andrew-abdelmalak/4-dof-service-manipulator/docs/4DOF_Service_Manipulator.pdf

# Design, Kinematic Analysis, and Experimental Validation of a 4-DOF Service Robotic Manipulator for Automated Beverage Preparation

Andrew Abdelmalak
Dept. of Mechatronics Engineering German University in Cairo (GUC) Cairo, Egypt

Daniel Boules
Dept. of Mechatronics Engineering German University in Cairo (GUC) Cairo, Egypt

David Girgis
Dept. of Mechatronics Engineering German University in Cairo (GUC) Cairo, Egypt

Kirolous Kirolous
Dept. of Mechatronics Engineering German University in Cairo (GUC) Cairo, Egypt

Samir Yacoub
Dept. of Mechatronics Engineering German University in Cairo (GUC) Cairo, Egypt

Youssef Salama
Dept. of Mechatronics Engineering German University in Cairo (GUC) Cairo, Egypt

Abstract—This paper presents the complete design, kinematic analysis, simulation, and experimental validation of a desktopscale 4-DOF service robotic manipulator for automated beverage preparation. The manipulator is constructed from 3D-printed PLA components and actuated by three MG996R high-torque servos and three SG90 micro servos. Kinematic modeling follows the Denavit–Hartenberg convention with link lengths d1 = 0.04355 m, a2 = 0.140 m, a3 = 0.133 m, and a4 = 0.109 m. A numerical Newton–Raphson inverse kinematics solver achieves sub-millimeter position convergence (< 10⁻⁴ m in ROS Python using Damped Least-Squares regularization with λ = 0.01, and < 10⁻³ m in MATLAB using the Moore–Penrose pseudoinverse), while warm-start joint recovery and undamped velocity roundtrip tests achieve machine-precision residuals (10⁻¹⁷ rad and ≤ 2.2 × 10⁻¹⁵ rad/s). Two task-space trajectories—a three-sided square path for pick-and-place operations and a circular path for stirring—are implemented and validated across Gazebo, Simscape Multibody, and physical hardware platforms. A tea-preparation demonstration involving sugar transport, spoon manipulation, and stirring confirms the system’s capability for coordinated multi-step service tasks using accessible, educationalgrade hardware.
Index Terms—Service robotics, robotic manipulator, Denavit– Hartenberg convention, inverse kinematics, trajectory planning, beverage preparation, 3D printing, Gazebo, Simscape.
I. INTRODUCTION
Service robotics is increasingly transforming customeroriented industries by automating tasks that demand consistency, hygiene, and precision. Among these applications, beverage preparation has emerged as a key domain where robots can deliver uniform quality while reducing human workload [1]. Recent studies have demonstrated the growing acceptance of robotic baristas and automated food preparation systems, where robots are valued for their ability to operate continuously without fatigue.
Several robotic coffee preparation systems have been proposed. Setiawan and Ma’arif [2] developed a PLC-based coffee-stirring system with PID control, demonstrating how controlled motion improves drink uniformity and prevents spillage. Michalkova et al. [3] automated an espresso machine ´ using a FANUC industrial arm and PLC logic, validating high-precision manipulators in cafe settings. Nurba et al. [4] ´ developed a 3-DOF manipulator applying Denavit–Hartenberg (DH) forward kinematics, achieving repeatability deviations below 0.06 mm. Salman et al. [5] employed the DH convention to model a 3-DOF arm with MATLAB GUI simulation and Arduino-based actuation, while Waluyo et al. [6] demonstrated an Arduino-based robot arm for coffee preparation. However, most existing systems either target industrialscale automation or are limited to single-function prototypes. Limited attention has been given to compact, educationalgrade manipulators tailored for multi-step service applications using accessible components. This paper addresses this gap through five contributions:
1) Design and fabrication of a 4-DOF desktop manipulator using 3D-printed parts and locally sourced servos.
2) Complete DH-based kinematic modeling including forward kinematics, numerical inverse kinematics, and velocity kinematics with analytical Jacobian derivation.
3) Dual-platform simulation validation in both Gazebo (ROS-integrated) and MATLAB Simscape Multibody.
4) Task-space trajectory planning with square (pick-andplace) and circular (stirring) paths.
5) Experimental validation on physical hardware through a tea-preparation demonstration.

II. SYSTEM DESIGN

A. Mechanical Architecture

The manipulator possesses 4 Degrees of Freedom (DOF) and is constructed primarily from 3D-printed PLA parts, ensuring a lightweight yet rigid structure (Fig. 1). The arm is actuated by six servo motors: three high-torque MG996R

(180◦
, metal gear) servos for the base, shoulder, and elbow joints, and three SG90 micro servos (180◦
, plastic gear) for
the wrist and gripper. One SG90 servo serves as a fixed dummy pivot to maintain the 4-DOF kinematic chain. Table I summarizes the primary components.

TABLE I: Hardware Components

Component | Qty
3D Printed Parts (PLA) | 1 set
MG996R Servo Motors | 3
SG90 Micro Servos | 3
Arduino Uno | 1
Power Supply (12V) | 1
B. End-Effector Design

A parallel gripper serves as the primary end-effector, providing sufficient range and gripping force for lightweight objects such as cups and utensils. The inner surfaces of the jaws are lined with high-friction material to ensure stable grasping. The same gripper can hold a teaspoon attachment for instant beverage preparation, dispensing coffee powder or sugar before stirring—preserving modularity without additional toolchanging mechanisms.

C. Electronics and Communication

The system is powered by a 12V DC supply with a DC-DC step-down converter for voltage regulation. Control logic is executed on an Arduino Uno, which generates PWM signals to control servo positions. Communication between the PC-based trajectory planner and the Arduino operates at 115,200 baud using comma-separated joint angle strings (e.g., "90,45,-30,0") with dedicated gripper commands
(GRIPPER_OPEN, GRIPPER_CLOSE). A handshake proto-
col using a "READY" acknowledgment signal ensures motion synchronization. Table II summarizes the pin assignments.

TABLE II: Arduino Pin Assignments and Calibration

Joint | Pin | Calibration
Base (J1) | 3 | q + 90◦
Shoulder (J2) | 5 | −q + 110◦
Elbow (J3) | 6 | −q + 90◦
Wrist (J4) | 9 | −q + 110◦
Gripper | 10 | q + 90◦ (clamped)

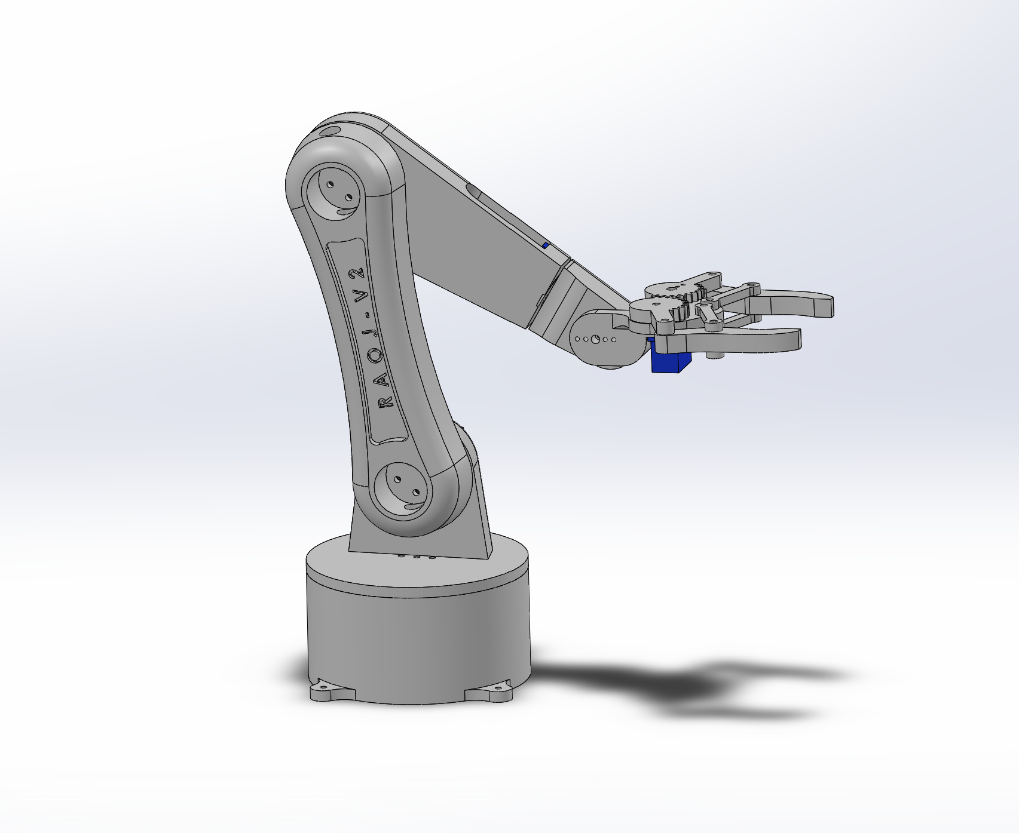
[picture p1: figure]

Fig. 1: CAD model of the 4-DOF robotic manipulator showing the joint arrangement and structural proportions.

III. KINEMATIC MODELING

A. Coordinate Frames and DH Parameters

Coordinate frames were assigned following the Denavit– Hartenberg convention [7], [8] using the X–Z rule (Fig. 2). The axes x1, x2, and x3 lie in the same plane, while z1 and z4 are parallel. The z3 axis is oriented opposite to z1 and z4, consistent with the DH convention for this manipulator. The resulting DH parameters are listed in Table III.

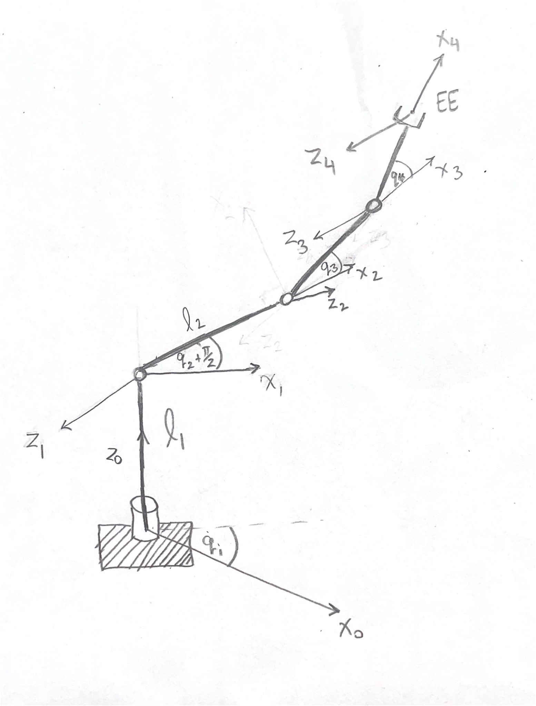
[picture p2: figure]

Fig. 2: Denavit–Hartenberg coordinate frame assignment for the 4-DOF manipulator.

TABLE III: Denavit–Hartenberg Parameters

Link | θi | di (m) | ai (m) | αi (rad)
1 | q1 | 0.04355 | 0 | π/2
2 | q2 + π/2 | 0 | 0.140 | π
3 | q3 | 0 | 0.133 | π
4 | q4 | 0 | 0.109 | 0
B. Forward Kinematics
The forward kinematics function F(q) computes the end-effector position X = [x, y, z]
| | T
from the joint vector q =
[q1, q2, q3, q4]

T
. Each link transformation is computed using the standard DH matrix:

i−1Ti =

cθi −sθi
cαi
| | sθi
| | sαi | aicθi
sθi | cθi
| cαi | −cθi
sαi | aisθi
0 | sαi | cαi | di
0 | 0 | 0 | 1

(1)

where cθi = cos θi and sθi = sin θi . The global transformation is obtained as 0T4 = 0T1 ·

1T2 ·

2T3 ·

3T4. For the zero joint
configuration (q1 = q2 = q3 = q4 = 0), the end-effector is elevated to z = 0.42555 m along the base z-axis, which equals d1 + a2 + a3 + a4 = 0.04355 + 0.140 + 0.133 + 0.109 m. The FK model was implemented identically in both MAT-
LAB (forward_kinematics_func.m) and Python (ROS
module forward_kinematics.py), ensuring consistent results across analytical computation and simulation.
C. Inverse Position Kinematics
Since the manipulator has 4 DOF but targets 3D Cartesian positions without full 6-DOF end-effector orientation constraints, the position kinematics problem is solved numerically using Newton–Raphson iterations over the 3 × 4 linear Jacobian. The position error is defined as:
ek = Xdes − F(qk) | (2)

In the ROS/Python implementation, the joint angle update uses a Damped Least-Squares (DLS) formulation:

∆q = J

T
v

(q)

Jv(q)J

T
v
(q) + λ

2
I3

−1
e | (3)

where Jv(q) ∈ R

3×4
is the analytical position Jacobian and λ = 0.01 is the damping factor for stability near singularities (whereas the MATLAB solver uses the undamped Moore– Penrose pseudoinverse J

+
v

(q)e).

D. Analytical Jacobian
The 3 × 4 position Jacobian Jv(q) = ∂F/∂q was derived analytically from F(q) = [−c1R, −s1R, d1 + l2c2 + l3cδ + l4cσ]

T
, where δ = q2 − q3, σ = q2 − q3 + q4, s1 = sin q1, c1 = cos q1, R = l2s2 + l3sδ + l4sσ, C = l2c2 + l3cδ + l4cσ, R′ = l3sδ + l4sσ, and C

′ = l3cδ + l4cσ:

Jv =

s1R | −c1C c1C
′ | −l4cσc1
−c1R −s1C s1C
′ | −l4cσs1
0 | −R | R′ | −l4sσ
- (4)

This analytical Jacobian matches central finite differences of F(q) to within 10⁻⁹
across random workspace configurations.
E. Velocity Kinematics

Forward velocity kinematics relates joint velocities q˙ to the end-effector twist V = [vx, vy, vz, ωx, ωy, ωz]

T via the 6 × 4
geometric Jacobian:

V = J(q) · q˙ =

Jv(q)
Jω(q)
q˙ | (5)

The inverse velocity kinematics recovers joint velocities from a desired twist using the pseudo-inverse:

q˙ = J

+(q) · Vdes | (6)

Validation was performed by commanding joint velocities in Gazebo, computing the theoretical end-effector velocity Vtheory = J(q)q˙ , and comparing it against the numerical velocity obtained from finite-difference position measurements. Both values showed close agreement, confirming the correctness of the Jacobian.

IV. TRAJECTORY PLANNING

The trajectory planner generates a sequence of end-effector positions X(t) = [x(t), y(t), z(t)]T
sampled at Ts = 0.1 s.
The IK solver converts these into joint angle sequences q(t).
A. Square Trajectory (Pick-and-Place)

The square trajectory is defined in the Y –Z plane as a three-sided “gate-like” path connecting four waypoints for pick-and-place operations. The motion sequence consists of:
(1) vertical ascent from the pickup location P1 to a safe height P2; (2) horizontal translation at the safe height to the drop-off column P3; and (3) vertical descent to the placement point P4. Position is linearly interpolated between consecutive waypoints:

P(t) = Pstart +

t
Tf
| (Pend − Pstart) | (7)

where Tf = 2.0 s per segment in MATLAB (3.0 s in the ROS trajectory node).

B. Circular Trajectory (Stirring)

The circular trajectory is defined in the X–Y plane for stirring operations. Given center C = [cx, cy, cz] and radius r:

θ(t) = 2π

Ttotal

| · t | (8)
x(t) = cx + r cos θ(t) | (9)
y(t) = cy + r sin θ(t) | (10)
z(t) = cz | (constant) | (11)

This ensures smooth continuous motion with constant angular velocity ω = 2π/Ttotal, where Ttotal = 10 s. Table IV summarizes the key planning parameters.

TABLE IV: Trajectory and IK Solver Parameters

Parameter | Value
Sampling time Ts | 0.1 s
Square segment duration Tf | 2.0 s (MATLAB) / 3.0 s (ROS)
Circle total duration Ttotal | 10 s
Damping factor λ | 0.01 (ROS DLS) / 0 (MATLAB pinv)
IK max iterations | 100 (MATLAB) / 500 (ROS)
Position tolerance ∥e∥ | 10⁻³ m (MATLAB) / 10⁻⁴ m (ROS)
V. SIMULATION AND VALIDATION
A. Dual-Platform Simulation

The kinematic model and trajectories were validated in two simulation environments: Gazebo (physics-based, ROS-integrated) and Simscape Multibody (system-level, MATLAB/Simulink). In Gazebo, Python ROS nodes published joint commands to the robot URDF model and queried the end-effector link pose via the /gazebo/get_link_state
service | (my_robot::EE_frame | at | 30 Hz,
republished | to | /end_effector_pose | by
ee_pose_from_gazebo.py). In Simscape, the CAD assembly was imported into Simulink with MATLAB Function blocks computing FK for direct comparison.
Both environments produced end-effector positions matching the analytical model for all tested configurations. Fig. 3 shows the robot models in both simulation environments.

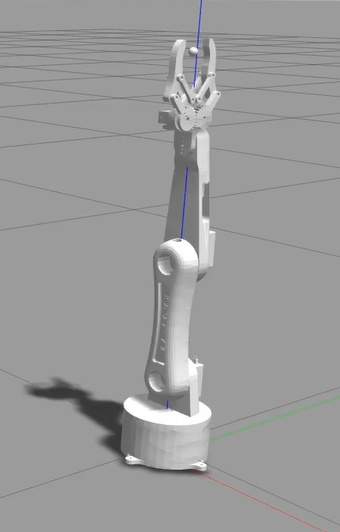
[picture p3: figure]
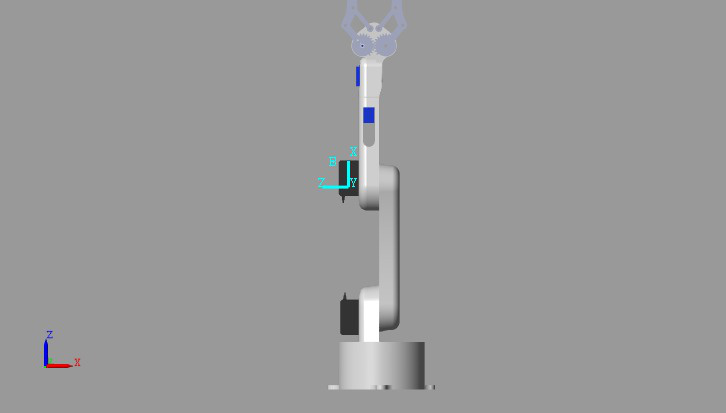
[picture p4: figure]

(a) Simscape Multibody | (b) Gazebo

Fig. 3: Robot models in both simulation environments.

B. Forward Kinematics Verification

Table V presents the FK verification results verified in both GNU Octave/MATLAB and Python, showing end-effector positions and velocities for two test configurations. The zeroconfiguration case yields the exact theoretical sum z = 0.42555 m (0.426 m rounded), confirming the DH parameter chain.

TABLE V: Kinematic Benchmark Test Cases

Case Input q (rad) | Output x (m) | Output V
1 | [0, 0, 0, 0] | [0, 0, 0.42555] | [0, 0, 0, 0, 0, 0.1]
2 | [0.2, 0.4, −0.3, 0.1] [−0.214, −0.043, 0.350] [−0.081, . . .]
C. Inverse Kinematics Roundtrip Validation

Three roundtrip tests were executed across both the Python solver (validate_roundtrip.py) and the Oc-
tave/MATLAB suite (test_velocity_kinematics.m),
summarized in Table VI. Starting from q0 = 0 (cold start), the position IK solver converges to within 5.66 × 10⁻⁵ m in Python (under 10⁻⁴ m tolerance) and 4.96 × 10⁻⁴ m in Octave/MATLAB. When warm-started at the target pose, ∥qrec − q∥ is zero to machine precision (≤ 1.39 × 10⁻¹⁷ rad). For velocity recovery, undamped Moore–Penrose pinv reproduces q˙ to 10⁻¹⁵ rad/s, whereas DLS regularization (λ = 0.01) introduces bounded bias up to 8.42 × 10⁻³
rad/s in exchange
for numerical stability near singularities.

TABLE VI: Python and Octave Roundtrip Validation

Case Input q (rad) | ∥ecold∥ (m) | ∥∆q˙ DLS∥ | ∥∆q˙ pinv∥
1 | [0, 0, 0, 0] | 0.00 | 1.00×10⁻⁵ | 0.00
2 | [0.2, 0.4, −0.3, 0.1] | 5.66×10⁻⁵ 5.00×10⁻³ 9.42×10⁻¹⁶
3 | [−0.3, 0.6, 0.2, −0.2] 5.45×10⁻⁵ 8.42×10⁻³ 1.18×10⁻¹⁵
D. Trajectory Validation

Both square and circular trajectories were executed in Gazebo and Simscape, with joint-angle sequences generated by the custom Python planner. Fig. 4 shows the trajectory validation results. For the square path, the four corners were traced with high fidelity and distinct transitions between linear segments. For the circular path, the end-effector maintained constant z-height while tracing a nearly perfect circle in the X–Y plane, with small deviations due to discretization and numerical IK residuals. The end-effector traces from Simscape closely matched Gazebo results, confirming cross-platform consistency despite differences in numerical integrators.

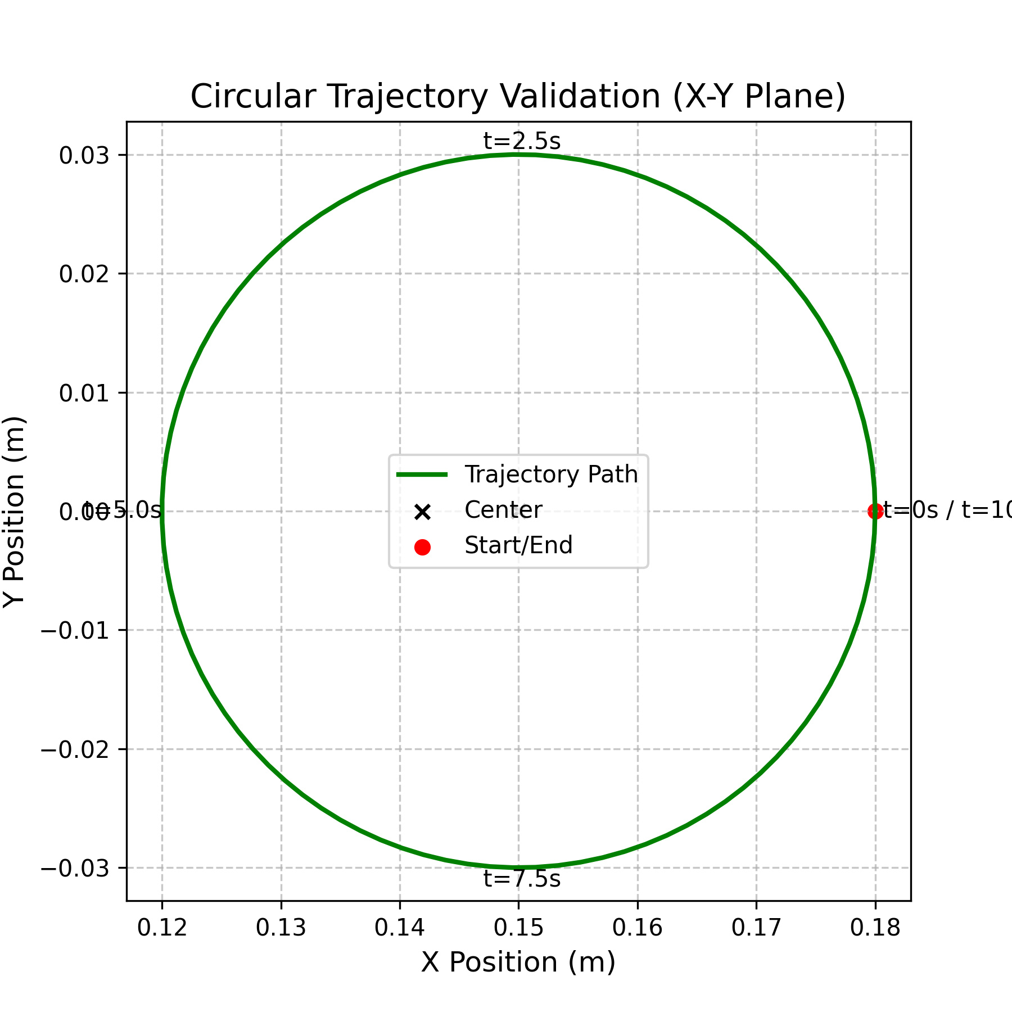
[picture p5: figure]
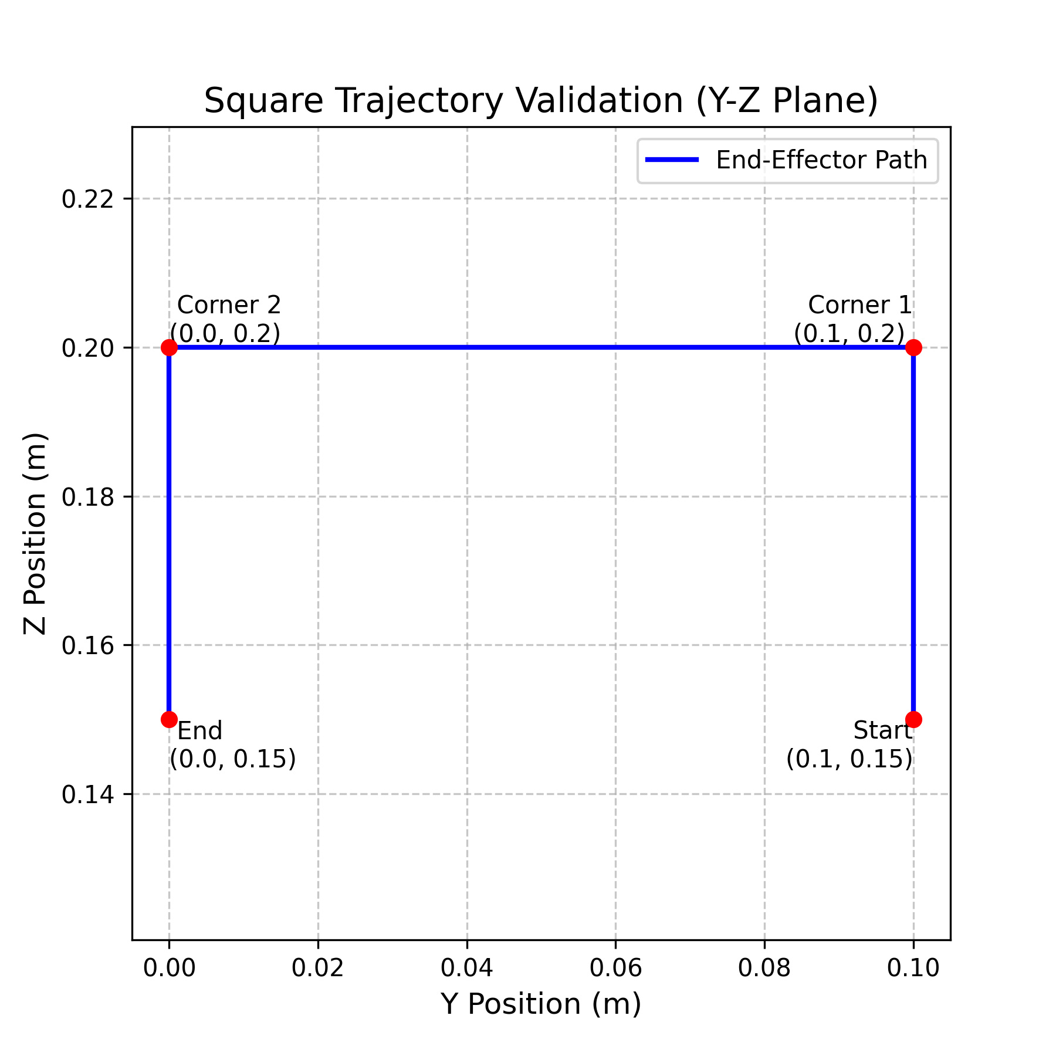
[picture p6: figure]

(a) Circular trajectory | (b) Square trajectory

Fig. 4: Task-space trajectory validation results from simulation.

VI. HARDWARE IMPLEMENTATION

A. Assembly and Wiring

The physical manipulator was fully assembled from 3D-printed PLA parts with all servo motors mounted at their respective joints (Fig. 6). The robot’s base is secured to a weighted wooden board to prevent tipping during highspeed movements. All electronics, including the Arduino Uno and motor connections, are housed in a protective enclosure. The circuit schematic (Fig. 5) shows the six servo motors connected to the Arduino’s PWM pins, with the 12V external power regulated through a DC-DC converter.

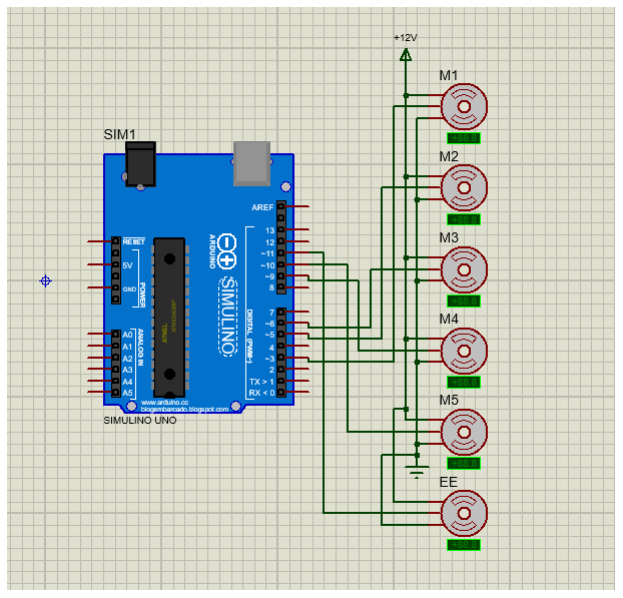
[picture p7: figure]

Fig. 5: Circuit schematic: Arduino Uno connected to six servo motors (M1–M5 and EE) via PWM pins, with 12V external power and common ground.

B. Open-Loop Validation

Initial hardware testing used Arduino scripts to sequentially actuate each motor through its full range of motion: base rotation, shoulder link, elbow link, wrist rotation, and gripper actuation. The fixed servo (motor 4) was confirmed stationary, consistent with the 4-DOF design. All active degrees of freedom responded correctly to commands, validating hardware readiness for trajectory execution.

C. Trajectory Execution

The joint-angle sequences computed by the trajectory planner were exported as CSV files and transmitted to the Arduino via a dedicated Python script (send_trajectory.py) that reads files line-by-line and waits for "READY" acknowledgments. The circular trajectory produced smooth, continuous motor movement, validating the 0.1 s time-step resolution. The square trajectory corners were reached with reasonable accuracy, with minor deviations attributed to mechanical backlash in servo gears and arm deflection under gravity at full extension.

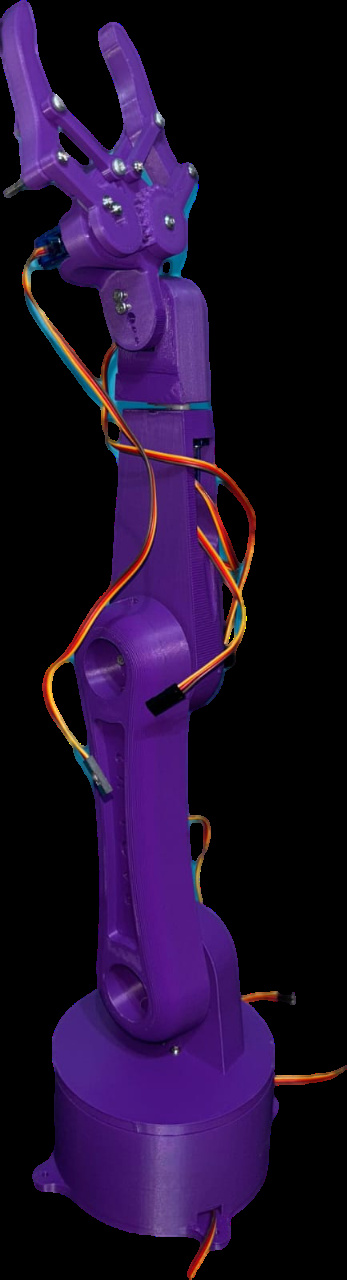
[picture p8: figure]

Fig. 6: Fully assembled 4-DOF robotic manipulator in the experimental setup.

VII. APPLICATION: TEA PREPARATION

The tea-preparation scenario serves as the primary validation task, demonstrating coordinated task-space motion and gripper actuation in a realistic service context. The complete task consists of five motion phases executed sequentially:

1) Sugar Transport: The manipulator executes the first square trajectory to pick up a sugar cube from its container, transport it, and release it into the cup.

2) Spoon Approach: A second square trajectory moves the end-effector to the spoon location and grasps the spoon handle.
3) Spoon Transport: The arm lifts the spoon and transports it toward the cup using a reverse square path.
4) Linear Centering: A short linear translation centers the spoon within the cup frame before stirring.
5) Stirring: The robot performs the circular trajectory for three full cycles (3 × 10 s), maintaining the spoon vertically inside the cup.
The complete 3D trajectory combining all phases is visualized in Fig. 7, illustrating the spatial relationship between the task objects (sugar container, spoon, cup) and the robot’s path.

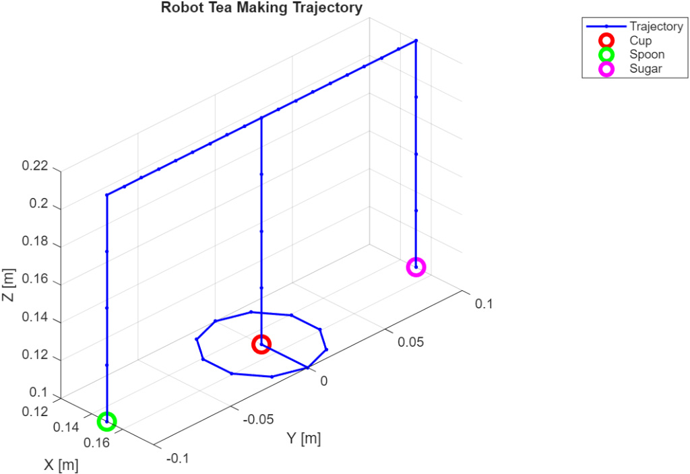
[picture p9: figure]

Fig. 7: 3D visualization of the complete tea-preparation trajectory, showing waypoints for sugar transport, spoon approach, and stirring.

Qualitatively, the hardware execution matched the simulation behavior. The square corners were clearly visible in the arm motion, and the circular stirring appeared smooth and repeatable. Small deviations from ideal paths arise from servo backlash, link flexibility, open-loop control, and slight misalignments between modeled and actual object positions. Despite these imperfections, the system successfully demonstrated coordinated multi-step manipulation in a practical service task.

VIII. DISCUSSION
The experimental results confirm that a low-cost, 3D-printed 4-DOF manipulator can perform multi-step beverage preparation tasks with acceptable repeatability for tabletop demonstrations. The DH-based kinematic model achieves sub-millimeter cold-start position convergence (< 10⁻⁴ m in ROS Python) and machine-precision velocity roundtrip residuals (≤ 2.2 × 10⁻¹⁵ rad/s under pinv), demonstrating that the analytical formulation is mathematically consistent across Octave/MATLAB and Python.
Two structural limitations shape the current platform. First, because the arm has 4 DOF operating in 3D workspace coordinates, position IK leaves end-effector orientation unconstrained rather than controlling full 6-DOF pose. Second, the physical hardware executes open-loop servo commands without encoder feedback, making joint angles susceptible to gear backlash and structural deflection under gravity, particularly at abrupt square-trajectory corners; the smoother circular trajectory exhibits noticeably less chatter.
The use of locally sourced components and 3D printing eliminates specialized industrial hardware, keeping the platform accessible for educational robotics laboratories.

IX. CONCLUSION
This paper presented the development of a 4-DOF service robotic manipulator, covering mechanical CAD design, DH kinematic modeling, ROS/Gazebo and Simscape simulation, and Arduino hardware execution. The analytical forward kinematics and Jacobian agree with finite-difference checks to 10⁻⁹

, cold-start position IK converges below 10⁻⁴ m, and undamped velocity roundtrip tests achieve 10⁻¹⁵ rad/s precision. Task-space square and circular trajectories were verified in simulation and demonstrated physically through a five-phase tea-preparation task.
Future work will focus on closed-loop joint or vision feedback to compensate for servo backlash and gravity droop, along with wrist-pitch orientation constraints during liquid handling.

REFERENCES

[1] S. Park, M. K. Park, J. Heo, J. S. Hwang, S. Hwang, D. Kim, S.-
J. Chung, and H. S. Kwak, “Robot versus human barista: Comparison of volatile compounds and consumers’ acceptance, sensory profile, and emotional response of brewed coffee,” Food Research International, vol. 172, p. 113119, 2023.
[2] A. Setiawan and A. Ma’arif, “Stirring system design for automatic coffee maker using OMRON PLC and PID control,” Int. J. Robotics and Control Systems, vol. 1, no. 3, pp. 390–401, 2021.
[3] S. Michalkova, K. Wojnarowsk ´ | y,´ S. Koleny ˇ | ak, M. Kantor, and J. Arm, ´
“Automating the handling process of a coffee machine using a robotic manipulator,” in Proc. XV Int. Symp. Industrial Electronics and Applications (INDEL), 2024, pp. 1–5.
[4] H. P. Nurba, D. Hadian, N. Lestari, K. A. Munastha, H. Mistialustina, and E. Rachmawati, “Performance evaluation of 3 DOF arm robot with forward kinematics Denavit–Hartenberg method for coffee maker machine,” in Proc. IEEE Int. Conf. Telecommunication Systems, Services, and Applications (TSSA), 2022, pp. 1–6.
[5] H. D. Salman, M. N. Hamzah, and S. H. Bakhy, “Kinematics analysis and implementation of three degrees of freedom robotic arm by using MATLAB,” The Iraqi Journal for Mechanical and Materials Engineering, vol. 21, no. 2, pp. 118–129, 2021.
[6] A. Waluyo, A. Tafrikhatin, and S. R. Heri, “Robot arm design for coffee maker Arduino based,” in Proc. 2nd Borobudur Int. Symposium on Science and Technology (BIS-STE 2020), Atlantis Press, 2021, pp. 438– 442.
[7] J. J. Craig, Introduction to Robotics: Mechanics and Control, 3rd ed. Pearson Prentice Hall, 2005.
[8] B. Siciliano, L. Sciavicco, L. Villani, and G. Oriolo, Robotics: Modelling, Planning and Control. Springer, 2009.
