andrew-abdelmalak/4-dof-service-manipulator/docs/assets/social-preview.png

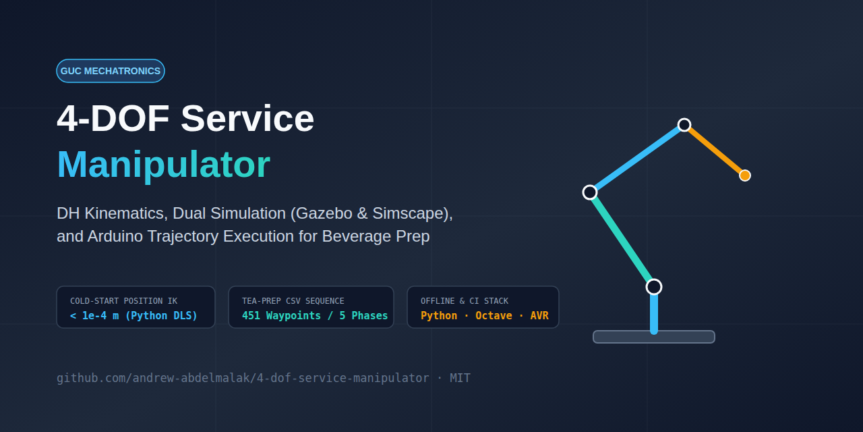
docs/assets/social-preview.png
