andrew-abdelmalak/4-dof-service-manipulator/(list of files, drawings)

Other design files:
hardware/actuator_connections.pdsprj
