andrew-abdelmalak/4-dof-service-manipulator/(commit log)

2026-03-19 Add Acknowledgments and References sections (Phase 2 audit fix)
    - Add ## Acknowledgments: project developed as part of GUC
    Mechatronics Engineering program
    - Add ## References: all 9 citations from the IEEE paper (Craig,
    Siciliano, Park, Setiawan, Michalková, Nurba, Salman, Saad, Waluyo)
    - Reorder end sections: Authors → Acknowledgments → References → License
2026-03-19 Add Proteus actuator connections circuit simulation (hardware/)
    [actuator_connections.pdsprj]
2026-11-13 Fix Python/ROS position IK, offline validation, CMake install, and Arduino sender
2026-11-13 Fix MATLAB/Octave kinematics shape handling and test assertions
2026-11-13 Pin Python dependencies with uv and add kinematics and trajectory test suite
2026-11-13 Update technical paper PDF to match code kinematics, validation results, and references
2026-11-14 Remove unused J: prefix from Arduino serial docs and dry-run
2026-11-14 Enforce repo-wide Ruff B/UP lint, formatting, and pinned Arduino CI tools
